oscar666666/ENEL387-STM32-Robot-Car/Schematic.pdf

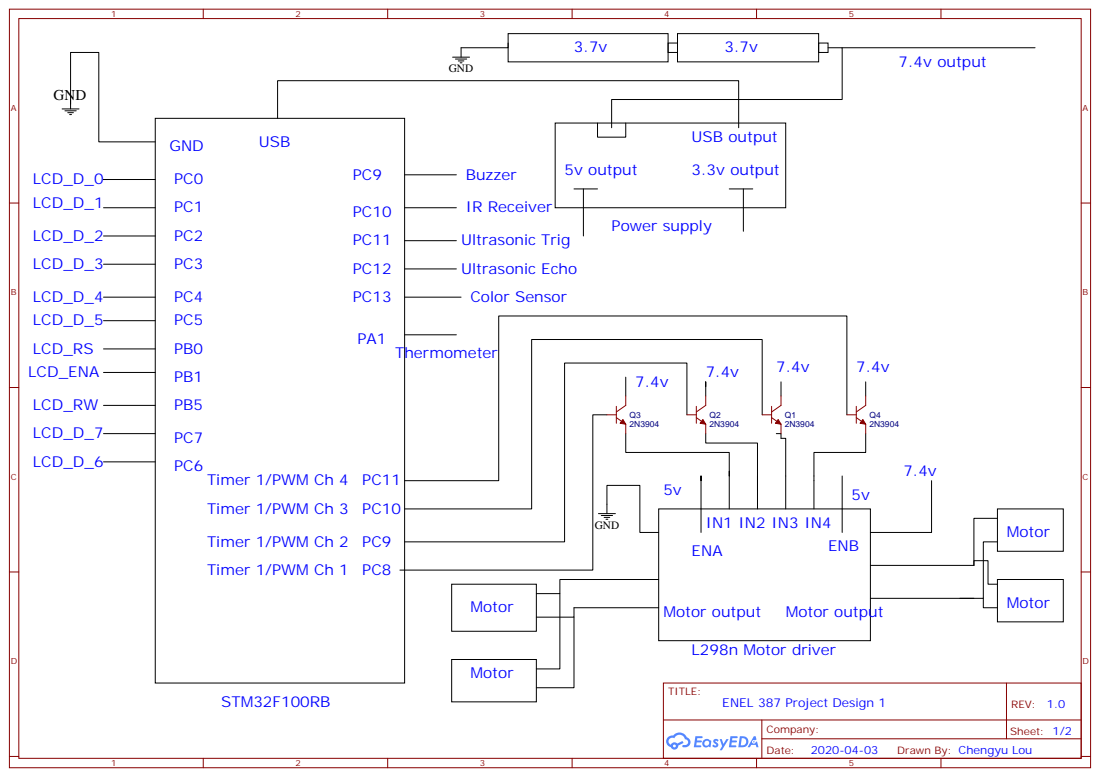
[picture p5: page 1]
TITLE:; ENEL 387 Project Design 1; REV: 1.0; Date:; Sheet: 1/2; Company:; USB; LCD_D_0; LCD_RS LCD_ENA; LCD_RW; LCD_D_7; LCD_D_6; LCD_D_1; LCD_D_2; LCD_D_3; LCD_D_4 LCD_D_5; GND; 7.4v output; 5v output; 3.3v output; USB output; ENA; ENB; L298n Motor driver; Timer 1/PWM Ch 1; Timer 1/PWM Ch 2; Timer 1/PWM Ch 3; Timer 1/PWM Ch 4; Motor; Motor output; STM32F100RB; Power supply; Buzzer; IR Receiver; Ultrasonic Trig; Ultrasonic Echo; Thermometer; Color Sensor

Drawn By: Chengyu Lou

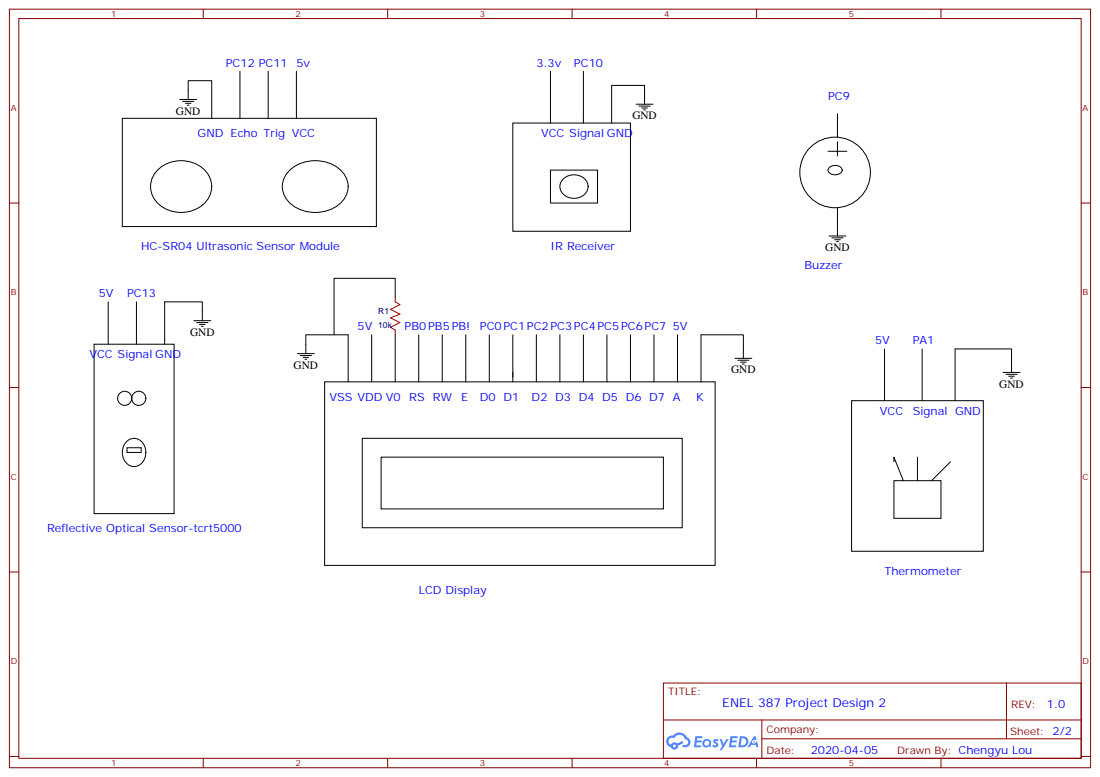
[picture p6: page 2]

GND Echo Trig VCC

Drawn By: Chengyu Lou
